RoqueIsaac/Sistema_Inalambrico_para_domotica/notas_instalacion.rtf

Instalación:

1. Copiar la carpeta “DB_Monitor” al directorio raíz, de tal manera que quede de la siguiente forma: C:\BD_Monitor

La carpeta anexa “DB_Monitor”, contiene los archivos necesarios para el correcto funcionamiento de la aplicación.

Los archivos dentro de ésta carpeta son:

1.
1. contador_logg.txt
2. contador1.txt
3. contador2.txt
4. LK__logger.udl
5. LK__tareas_prog5.udl
6. logger.mdb
7. tareas_prog5.mdb

En los archivos .txt contienen el registro de los contadores para las bases de datos.

Los archivos .udl son los archivos de tipo Linker que utiliza Labview para comunicarse con las bases de datos.

Los archivos .mdb son las bases de datos, en una se almacena el logger (cambios realizados) y en la otra las tareas programadas.
