RoqueIsaac/Sistema_Inalambrico_para_domotica/(list of files, drawings)

Other design files:
proteus_sim/pic_serial.pdsprj
